Ralim/Open-BMS/README.md

# Open-BMS
ISL94202 &amp; MSP430 based BMS

This is the source files for the Open BMS Designed by Ben V. Brown.
Documentation is currently over at [Hackaday.io](https://hackaday.io/project/25512-open-bms).
