Ralim/Open-BMS/Electronics/BMS GUI/Front Panel.pdf

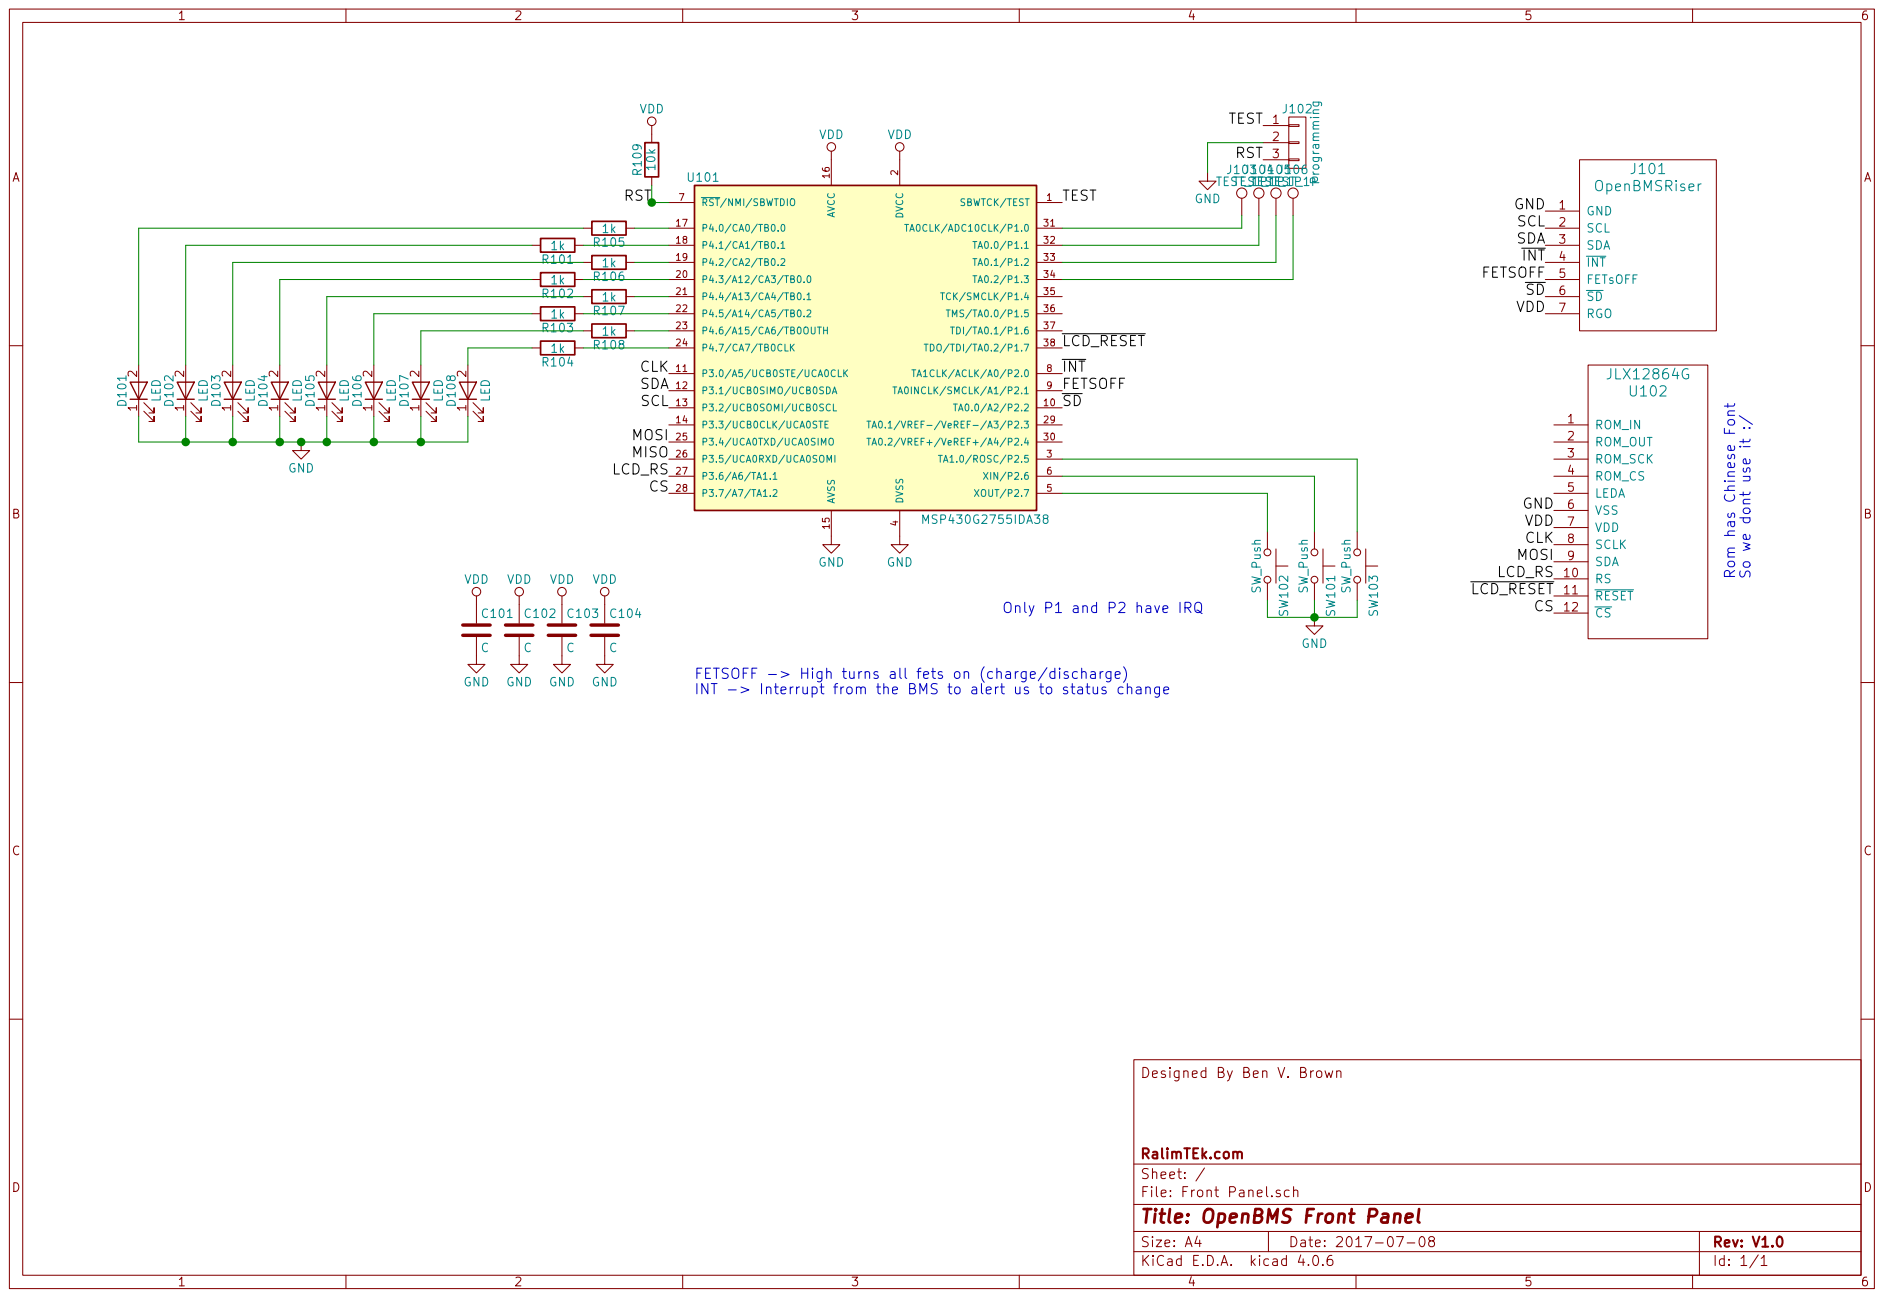
[picture p1: page 1]

4 XOUT/P2.7 5 XIN/P2.6 6 RST/NMI/SBWTDIO 7 TA1CLK/ACLK/A0/P2.0 8 TA0INCLK/SMCLK/A1/P2.1 9 TA0.0/A2/P2.2 10 P4.3/A12/CA3/TB0.0 20 TA0.2/VREF+/VeREF+/A4/P2.4 30 P3.0/A5/UCB0STE/UCA0CLK 11 P4.4/A13/CA4/TB0.1 21 TA0CLK/ADC10CLK/P1.0 31 P3.1/UCB0SIMO/UCB0SDA 12 P4.5/A14/CA5/TB0.2 22 TA0.0/P1.1 32 P3.2/UCB0SOMI/UCB0SCL 13 P4.6/A15/CA6/TB0OUTH 23 TA0.1/P1.2 33 P3.3/UCB0CLK/UCA0STE 14 P4.7/CA7/TB0CLK 24 TA0.2/P1.3 34 AVSS 15 P3.4/UCA0TXD/UCA0SIMO 25 TCK/SMCLK/P1.4 35 AVCC 16 P3.5/UCA0RXD/UCA0SOMI 26 TMS/TA0.0/P1.5 36 P4.0/CA0/TB0.0 17 P3.6/A6/TA1.1 27 TDI/TA0.1/P1.6 37 P4.1/CA1/TB0.1 18 P3.7/A7/TA1.2 28 TDO/TDI/TA0.2/P1.7 38 P4.2/CA2/TB0.2 19 TA0.1/VREF/VeREF/A3/P2.3 29 U101 MSP430G2755IDA38 VDD VDD GND GND GND 1 SCL 2 SDA 3

RST GND Only P1 and P2 have IRQ

FETSOFF -> High turns all fets on (charge/discharge)
INT -> Interrupt from the BMS to alert us to status change

Designed By Ben V. Brown

Id: 1/1 Title: OpenBMS Front Panel File: Front Panel.sch Sheet: / RalimTEk.com
