Ralim/Open-BMS/Electronics/Power Dist/Power Dist.kicad_pcb

## KiCad design Electronics/Power Dist/Power Dist.kicad_pcb (2017-08-22)

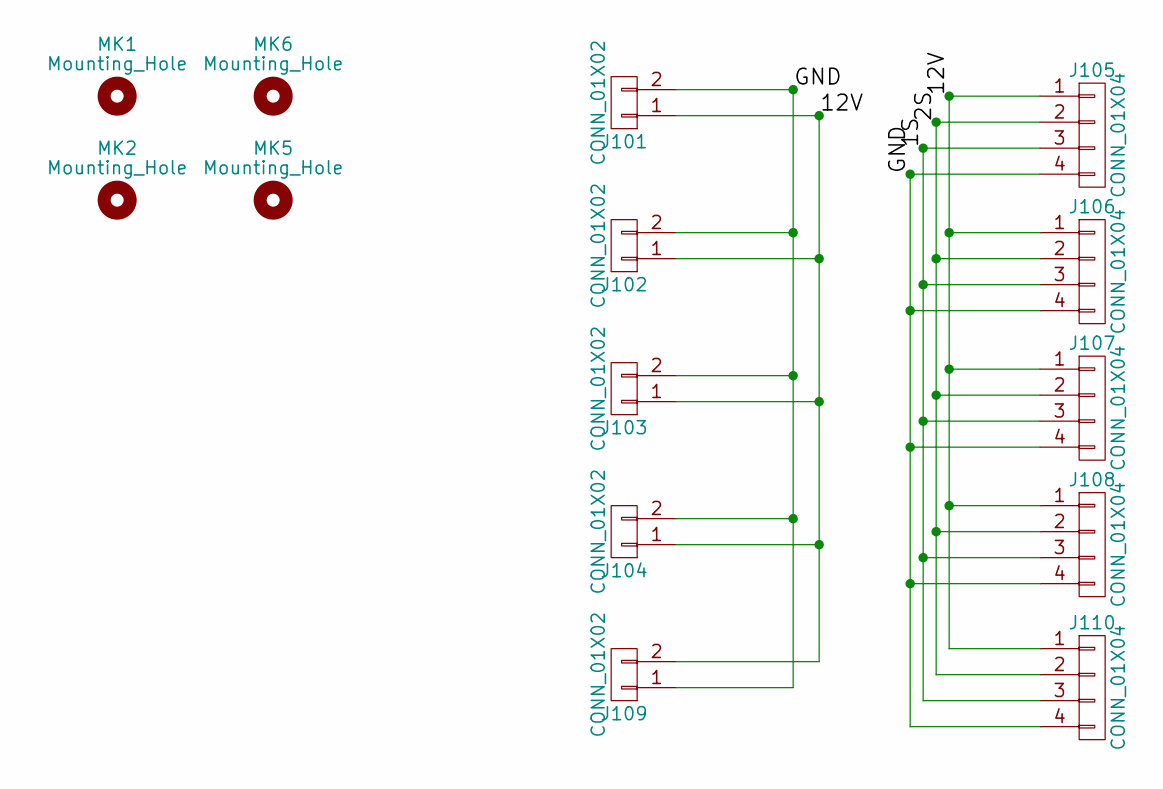
[picture p2: schematic Power Dist.sch]

Parts:
J101: CONN_01X02; XT30PW_Female
J102, J103, J104: CONN_01X02; XT30PW_Male
J105, J106, J107, J108: CONN_01X04; JST_XH_S04B-XH-A_04x2.50mm_Angled
J109: CONN_01X02; XT30
J110: CONN_01X04; JST_XH_B04B-XH-A_04x2.50mm_Straight
MK1, MK2, MK5, MK6: Mounting_Hole; MountingHole_3.2mm_M3

Connections:
/1S: J105.3, J106.3, J107.3, J108.3, J110.3
/2S: J105.2, J106.2, J107.2, J108.2, J110.2
/12V: J101.1, J102.1, J103.1, J104.1, J105.1, J106.1, J107.1, J108.1, J109.2, J110.1
/GND: J101.2, J102.2, J103.2, J104.2, J105.4, J106.4, J107.4, J108.4, J109.1, J110.4

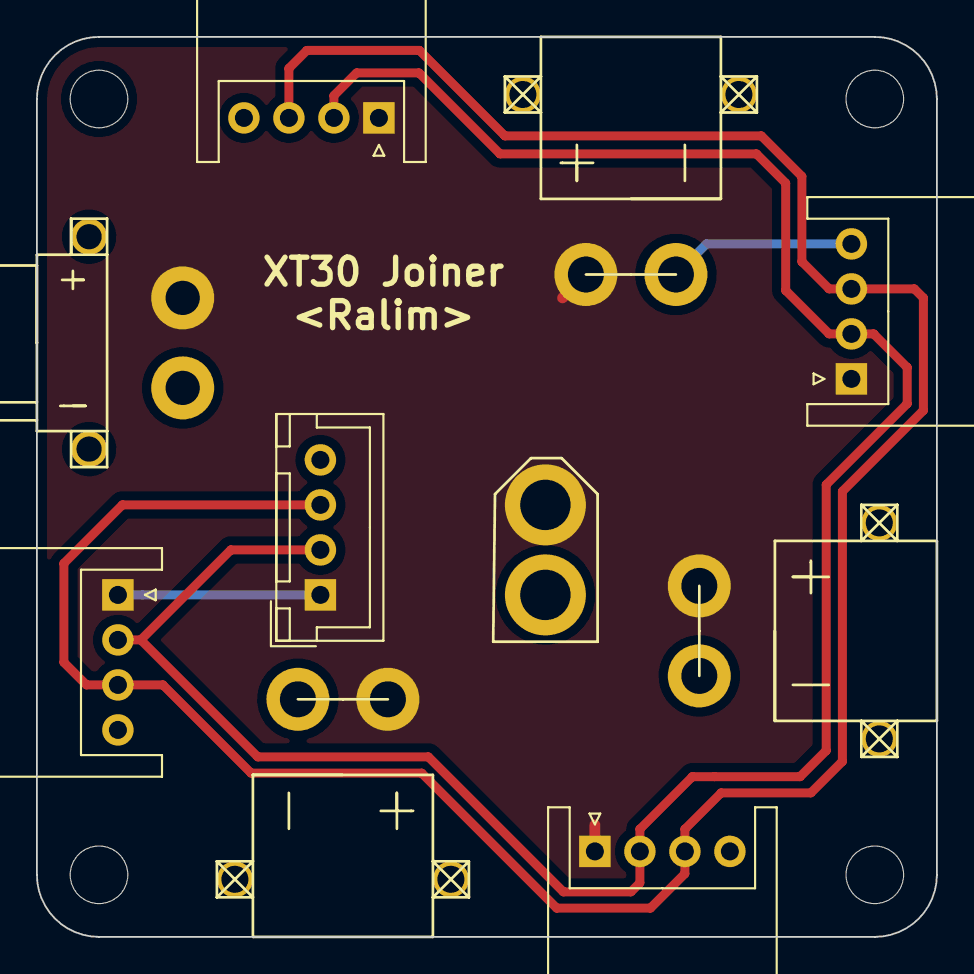
[picture p3: board Power Dist.kicad_pcb from above]

Board: 2 copper layers, 50.0 x 50.0 mm, 14 parts (0 on the bottom side), 4 nets.
