Ralim/Open-BMS/Electronics/BMS GUI/Front Panel.kicad_pcb

## KiCad design Electronics/BMS GUI/Front Panel.kicad_pcb (2017-07-08)

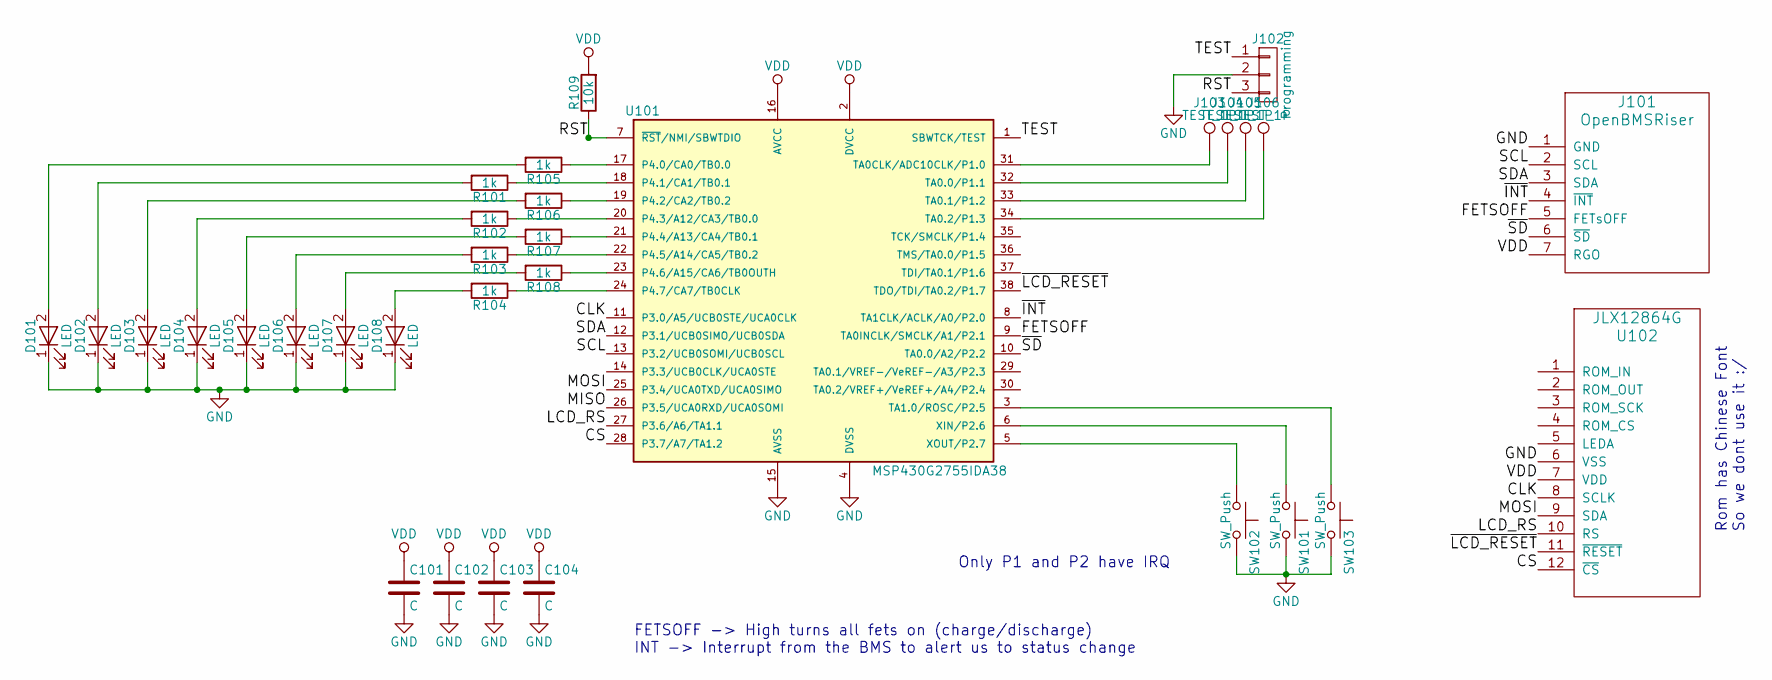
[picture p4: schematic Front Panel.sch, OpenBMS Front Panel]

Parts:
C101, C102, C103, C104: C; C_0603
D101, D102, D103, D104, D105, D106, D107, D108: LED; LED_0805
J101: OpenBMSRiser
J102: Programming; Pin_Header_Angled_1x03_Pitch2.54mm
J103, J104, J105, J106: TEST_1P; TEST-SMD-SMALL
R101, R102, R103, R104, R105, R106, R107, R108: 1k; R_0603
R109: 10k; R_0603
SW101, SW102, SW103: SW_Push; SW_SPST_TL3342
U101: MSP430G2755IDA38; TSSOP-38_4.4x9.7mm_Pitch0.5mm
U102: JLX12864G

Connections:
/CLK: U101.11 (P3.0/A5/UCB0STE/UCA0CLK), U102.8 (SCLK)
/CS: U101.28 (P3.7/A7/TA1.2), U102.12 (~CS)
/FETSOFF: J101.5 (FETsOFF), U101.9 (TA0INCLK/SMCLK/A1/P2.1)
/LCD_RS: U101.27 (P3.6/A6/TA1.1), U102.10 (RS)
/MOSI: U101.25 (P3.4/UCA0TXD/UCA0SIMO), U102.9 (SDA)
/RST: J102.3, R109.1, U101.7 (~RST~/NMI/SBWTDIO)
/SCL: J101.2 (SCL), U101.13 (P3.2/UCB0SOMI/UCB0SCL)
/SDA: J101.3 (SDA), U101.12 (P3.1/UCB0SIMO/UCB0SDA)
/TEST: J102.1, U101.1 (SBWTCK/TEST)
/~INT: J101.4 (~INT), U101.8 (TA1CLK/ACLK/A0/P2.0)
/~LCD_RESET: U101.38 (TDO/TDI/TA0.2/P1.7), U102.11 (~RESET)
/~SD: J101.6 (~SD), U101.10 (TA0.0/A2/P2.2)
GND: C101.2, C102.2, C103.2, C104.2, D101.1 (K), D102.1 (K), D103.1 (K), D104.1 (K), D105.1 (K), D106.1 (K), D107.1 (K), D108.1 (K), J101.1 (GND), J102.2, SW101.2, SW102.2, SW103.2, U101.4 (DVSS), U101.15 (AVSS), U102.6 (VSS)
unnamed: D101.2 (A), R105.2
unnamed: D102.2 (A), R101.2
unnamed: D103.2 (A), R106.2
unnamed: D104.2 (A), R102.2
unnamed: D105.2 (A), R107.2
unnamed: D106.2 (A), R103.2
unnamed: D107.2 (A), R108.2
unnamed: D108.2 (A), R104.2
unnamed: J103.1, U101.31 (TA0CLK/ADC10CLK/P1.0)
unnamed: J104.1, U101.32 (TA0.0/P1.1)
unnamed: J105.1, U101.33 (TA0.1/P1.2)
unnamed: J106.1, U101.34 (TA0.2/P1.3)
unnamed: R101.1, U101.18 (P4.1/CA1/TB0.1)
unnamed: R102.1, U101.20 (P4.3/A12/CA3/TB0.0)
unnamed: R103.1, U101.22 (P4.5/A14/CA5/TB0.2)
unnamed: R104.1, U101.24 (P4.7/CA7/TB0CLK)
unnamed: R105.1, U101.17 (P4.0/CA0/TB0.0)
unnamed: R106.1, U101.19 (P4.2/CA2/TB0.2)
unnamed: R107.1, U101.21 (P4.4/A13/CA4/TB0.1)
unnamed: R108.1, U101.23 (P4.6/A15/CA6/TB0OUTH)
unnamed: SW101.1, U101.6 (XIN/P2.6)
unnamed: SW102.1, U101.5 (XOUT/P2.7)
unnamed: SW103.1, U101.3 (TA1.0/ROSC/P2.5)
VDD: C101.1, C102.1, C103.1, C104.1, J101.7 (RGO), R109.2, U101.2 (DVCC), U101.16 (AVCC), U102.7 (VDD)

Notes on the sheet:
Rom has Chinese Font So we dont use it :/
Only P1 and P2 have IRQ
FETSOFF -> High turns all fets on (charge/discharge) INT -> Interrupt from the BMS to alert us to status change

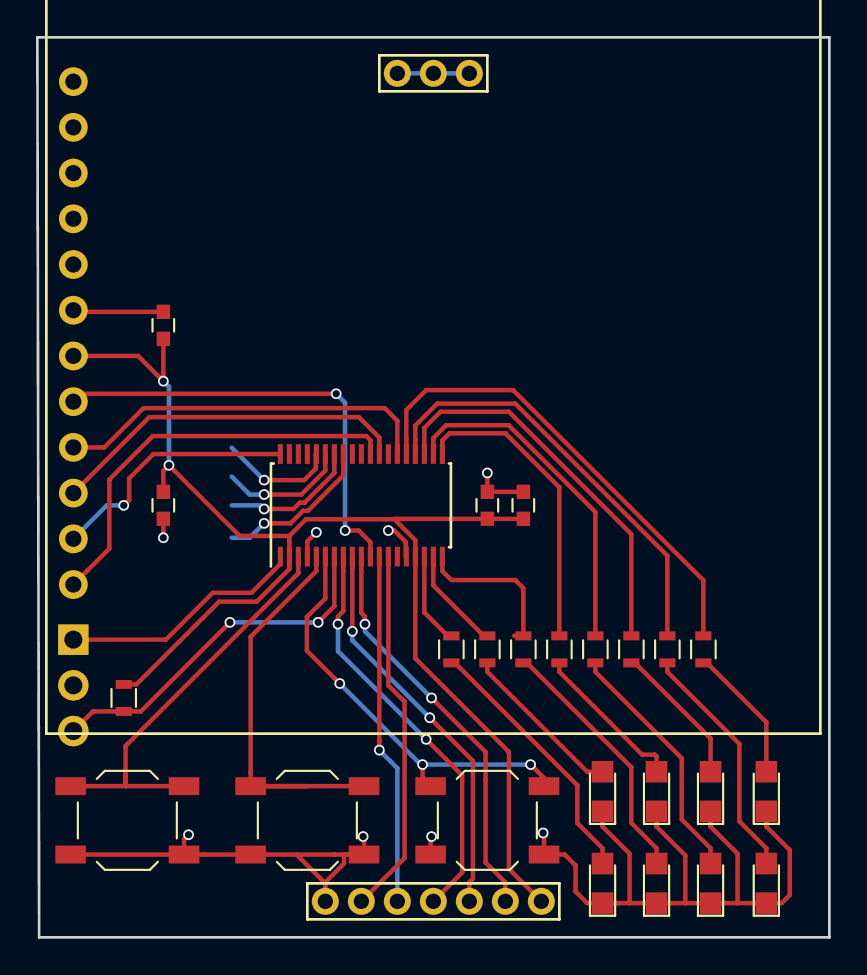
[picture p5: board Front Panel.kicad_pcb from above]

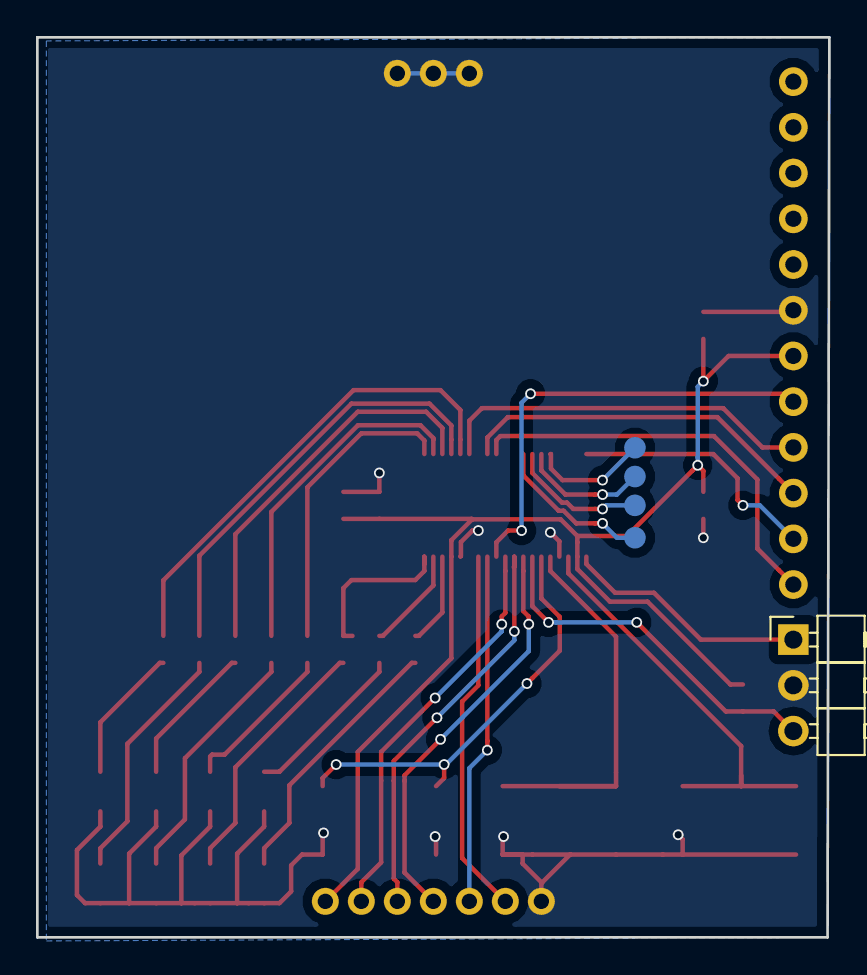
[picture p6: board Front Panel.kicad_pcb from below]

Board: 2 copper layers, 44.0 x 50.0 mm, 32 parts (5 on the bottom side), 37 nets.
