Ralim/Open-BMS/Electronics/BMS FrontEnd/OpenBMSFrontEnd.kicad_pcb

## KiCad design Electronics/BMS FrontEnd/OpenBMSFrontEnd.kicad_pcb (2017-06-20)

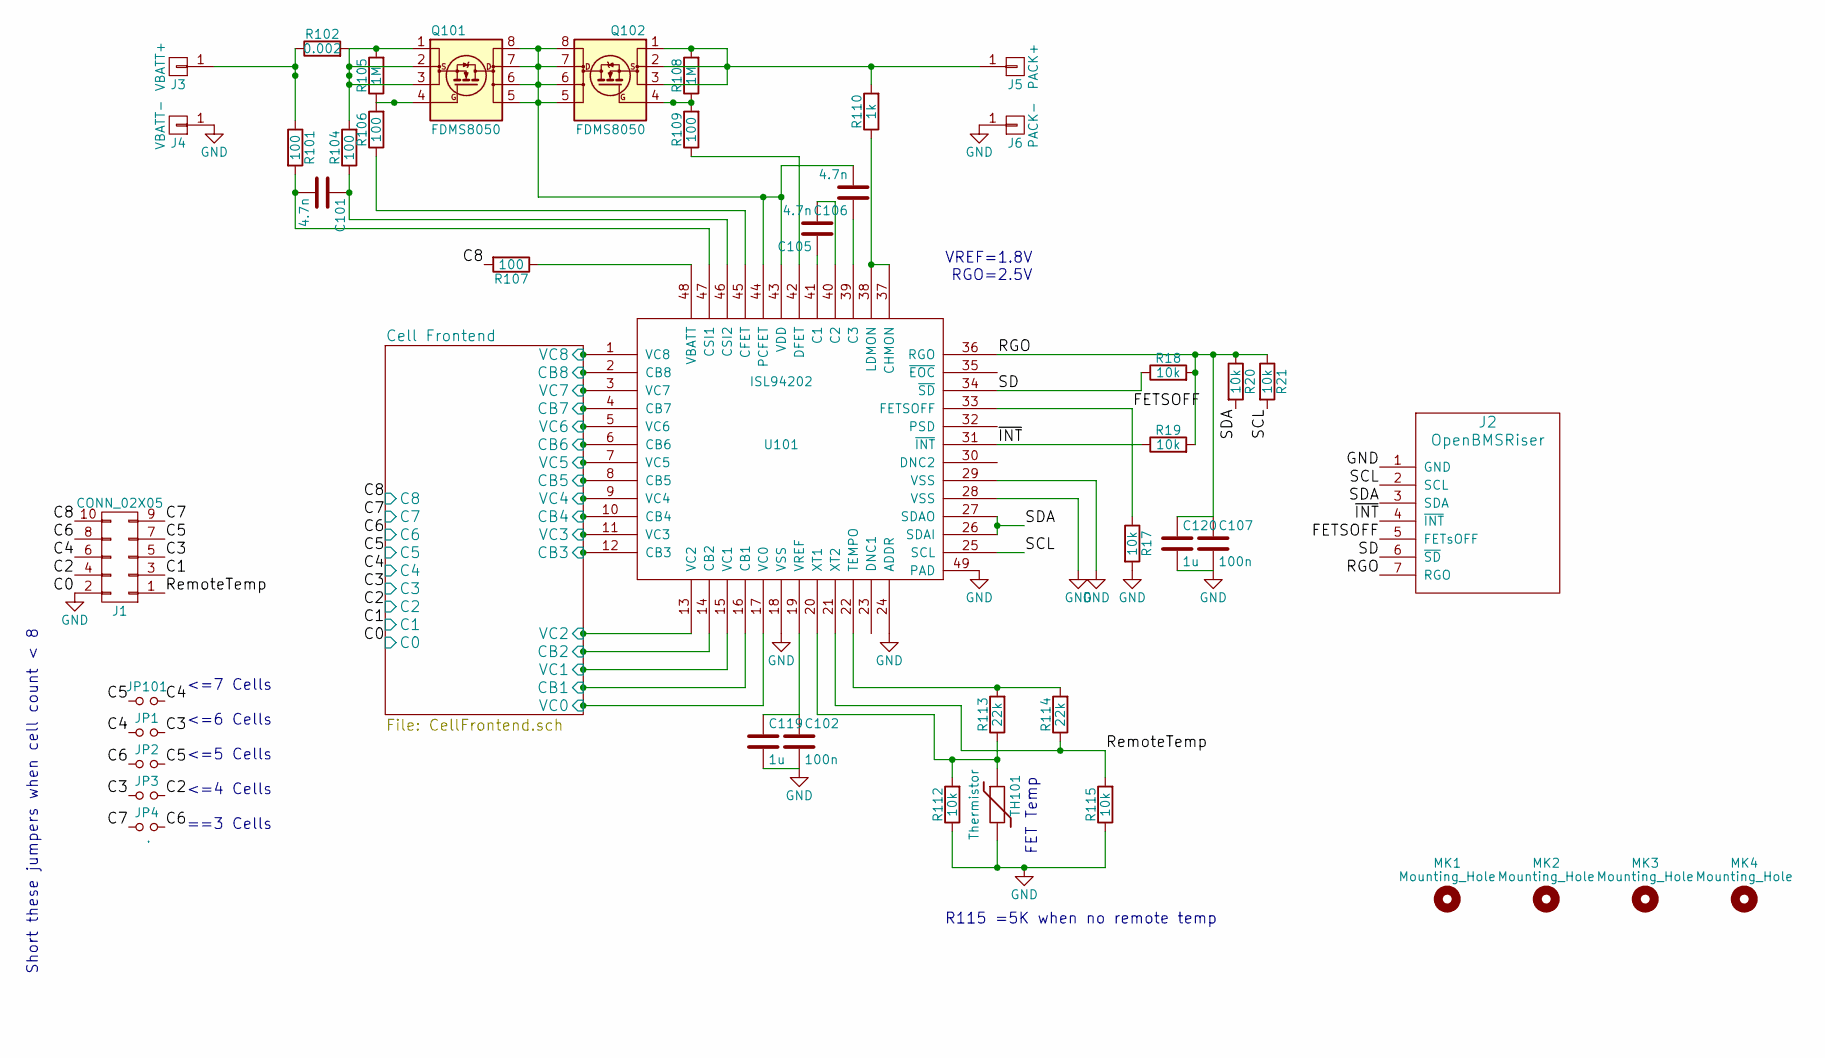
[picture p7: schematic OpenBMSFrontEnd.sch, Open BMS Front End]

Parts:
C101, C105, C106: 4.7n; C_0603
C102, C107: 100n; C_0603
C119, C120: 1u; C_0603
J1: CONN_02X05; IDC_Header_Straight_10pins
J2: OpenBMSRiser
J3: VBATT+; SolderWirePad_single_2mmDrill
J4: VBATT-; SolderWirePad_single_2mmDrill
J5: PACK+; SolderWirePad_single_2mmDrill
J6: PACK-; SolderWirePad_single_2mmDrill
JP1, JP2, JP3, JP4, JP101: .; JUMPER-SOLDER-SMD
MK1, MK2, MK3, MK4: Mounting_Hole; MountingHole_3.2mm_M3
Q101, Q102: FDMS8050; TDSON-8-1
R17, R18, R19, R20, R21, R112, R115: 10k; R_0603
R101, R104, R106, R107, R109: 100; R_0603
R102: 0.002; R_2512
R105, R108: 1M; R_0603
R110: 1k; R_0603
R113, R114: 22k; R_0603
TH101: Thermistor; R_0603
U101: ISL94202; UQFN-48-1EP_6x6mm_Pitch0.4mm

Connections:
/C1: J1.3; also elsewhere on the board
/C2: J1.4, JP3.2; also elsewhere on the board
/C3: J1.5, JP1.2, JP3.1; also elsewhere on the board
/C4: J1.6, JP1.1, JP101.2; also elsewhere on the board
/C5: J1.7, JP2.2, JP101.1; also elsewhere on the board
/C6: J1.8, JP2.1, JP4.2; also elsewhere on the board
/C7: J1.9, JP4.1; also elsewhere on the board
/C8: J1.10, R107.2; also elsewhere on the board
/Cell Frontend/CB1: U101.16 (CB1); also elsewhere on the board
/Cell Frontend/CB2: U101.14 (CB2); also elsewhere on the board
/Cell Frontend/CB3: U101.12 (CB3); also elsewhere on the board
/Cell Frontend/CB4: U101.10 (CB4); also elsewhere on the board
/Cell Frontend/CB5: U101.8 (CB5); also elsewhere on the board
/Cell Frontend/CB6: U101.6 (CB6); also elsewhere on the board
/Cell Frontend/CB7: U101.4 (CB7); also elsewhere on the board
/Cell Frontend/CB8: U101.2 (CB8); also elsewhere on the board
/Cell Frontend/VC0: U101.17 (VC0); also elsewhere on the board
/Cell Frontend/VC1: U101.15 (VC1); also elsewhere on the board
/Cell Frontend/VC2: U101.13 (VC2); also elsewhere on the board
/Cell Frontend/VC3: U101.11 (VC3); also elsewhere on the board
/Cell Frontend/VC4: U101.9 (VC4); also elsewhere on the board
/Cell Frontend/VC5: U101.7 (VC5); also elsewhere on the board
/Cell Frontend/VC6: U101.5 (VC6); also elsewhere on the board
/Cell Frontend/VC7: U101.3 (VC7); also elsewhere on the board
/Cell Frontend/VC8: U101.1 (VC8); also elsewhere on the board
/FETSOFF: J2.5 (FETsOFF), R17.1, U101.33 (FETSOFF)
/RGO: C107.1, C120.1, J2.7 (RGO), R18.2, R19.2, R20.1, R21.1, U101.36 (RGO)
/RemoteTemp: J1.1, R114.1, R115.2, U101.21 (XT2)
/SCL: J2.2 (SCL), R21.2, U101.25 (SCL)
/SD: J2.6 (~SD), R18.1, U101.34 (~SD)
/SDA: J2.3 (SDA), R20.2, U101.26 (SDAI), U101.27 (SDAO)
/~INT: J2.4 (~INT), R19.1, U101.31 (~INT)
GND: C102.2, C107.2, C119.2, C120.2, J1.2, J2.1 (GND), J4.1, J6.1, R17.2, R112.1, R115.1, TH101.2, U101.18 (VSS), U101.24 (ADDR), U101.28 (VSS), U101.29 (VSS), U101.49 (PAD); also elsewhere on the board
unnamed: C101.1, R104.1, U101.46 (CSI2)
unnamed: C101.2, R101.2, U101.47 (CSI1)
unnamed: C102.1, C119.1, U101.19 (VREF)
unnamed: C105.1, U101.41 (C1)
unnamed: C105.2, U101.40 (C2)
unnamed: C106.1, U101.39 (C3)
unnamed: C106.2, Q101.5 (D), Q101.6 (D), Q101.7 (D), Q101.8 (D), Q102.5 (D), Q102.6 (D), Q102.7 (D), Q102.8 (D), U101.43 (VDD), U101.44 (PCFET)
unnamed: J3.1, R101.1, R102.1
unnamed: J5.1, Q102.1 (S), Q102.2 (S), Q102.3 (S), R108.2, R110.2
unnamed: Q101.1 (S), Q101.2 (S), Q101.3 (S), R102.2, R104.2, R105.2
unnamed: Q101.4 (G), R105.1, R106.2
unnamed: Q102.4 (G), R108.1, R109.2
unnamed: R106.1, U101.45 (CFET)
unnamed: R107.1, U101.48 (VBATT)
unnamed: R109.1, U101.42 (DFET)
unnamed: R110.1, U101.37 (CHMON), U101.38 (LDMON)
unnamed: R112.2, R113.1, TH101.1, U101.20 (XT1)
unnamed: R113.2, R114.2, U101.22 (TEMPO)

Notes on the sheet:
VREF=1.8V RGO=2.5V
FET Temp
<=7 Cells <=6 Cells <=5 Cells <=4 Cells ==3 Cells
Short these jumpers when cell count < 8
R115 =5K when no remote temp

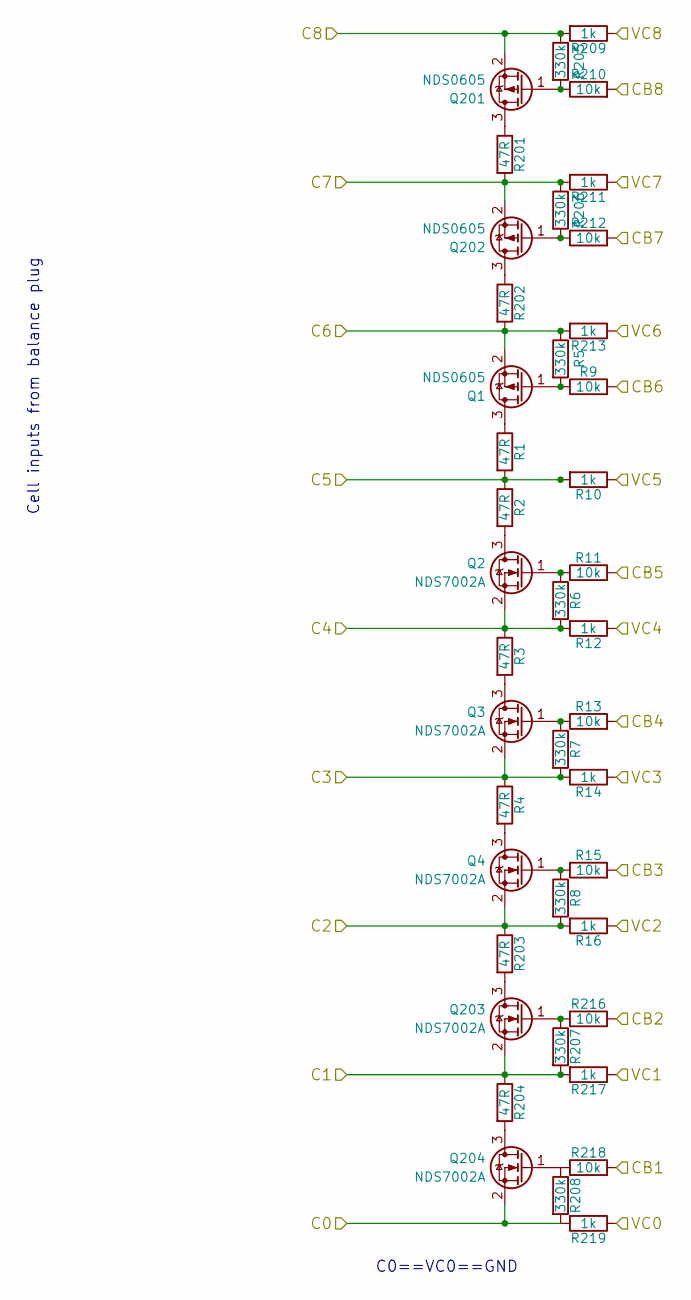
[picture p8: schematic CellFrontend.sch, BMS Front End Balancing Drive]

Parts:
Q1, Q201, Q202: NDS0605; SOT-23
Q2, Q3, Q4, Q203, Q204: NDS7002A; SOT-23
R1, R2, R3, R4, R201, R202, R203, R204: 47R; R_0805
R5, R6, R7, R8, R205, R206, R207, R208: 330k; R_0603
R9, R11, R13, R15, R210, R212, R216, R218: 10k; R_0603
R10, R12, R14, R16, R209, R211, R213, R217, R219: 1k; R_0603

Connections:
/C1: Q203.2 (S), R204.1, R207.2, R217.2; also elsewhere on the board
/C2: Q4.2 (S), R8.2, R16.2, R203.1; also elsewhere on the board
/C3: Q3.2 (S), R4.1, R7.2, R14.2; also elsewhere on the board
/C4: Q2.2 (S), R3.1, R6.2, R12.2; also elsewhere on the board
/C5: R1.2, R2.1, R10.2; also elsewhere on the board
/C6: Q1.2 (S), R5.1, R202.2, R213.2; also elsewhere on the board
/C7: Q202.2 (S), R201.2, R206.1, R211.2; also elsewhere on the board
/C8: Q201.2 (S), R205.1, R209.2; also elsewhere on the board
/Cell Frontend/CB1: R218.2; also elsewhere on the board
/Cell Frontend/CB2: R216.2; also elsewhere on the board
/Cell Frontend/CB3: R15.2; also elsewhere on the board
/Cell Frontend/CB4: R13.2; also elsewhere on the board
/Cell Frontend/CB5: R11.2; also elsewhere on the board
/Cell Frontend/CB6: R9.2; also elsewhere on the board
/Cell Frontend/CB7: R212.2; also elsewhere on the board
/Cell Frontend/CB8: R210.2; also elsewhere on the board
/Cell Frontend/VC0: R219.1; also elsewhere on the board
/Cell Frontend/VC1: R217.1; also elsewhere on the board
/Cell Frontend/VC2: R16.1; also elsewhere on the board
/Cell Frontend/VC3: R14.1; also elsewhere on the board
/Cell Frontend/VC4: R12.1; also elsewhere on the board
/Cell Frontend/VC5: R10.1; also elsewhere on the board
/Cell Frontend/VC6: R213.1; also elsewhere on the board
/Cell Frontend/VC7: R211.1; also elsewhere on the board
/Cell Frontend/VC8: R209.1; also elsewhere on the board
GND: Q204.2 (S), R208.2, R219.2; also elsewhere on the board
unnamed: Q1.1 (G), R5.2, R9.1
unnamed: Q1.3 (D), R1.1
unnamed: Q2.1 (G), R6.1, R11.1
unnamed: Q2.3 (D), R2.2
unnamed: Q3.1 (G), R7.1, R13.1
unnamed: Q3.3 (D), R3.2
unnamed: Q4.1 (G), R8.1, R15.1
unnamed: Q4.3 (D), R4.2
unnamed: Q201.1 (G), R205.2, R210.1
unnamed: Q201.3 (D), R201.1
unnamed: Q202.1 (G), R206.2, R212.1
unnamed: Q202.3 (D), R202.1
unnamed: Q203.1 (G), R207.1, R216.1
unnamed: Q203.3 (D), R203.2
unnamed: Q204.1 (G), R208.1, R218.1
unnamed: Q204.3 (D), R204.2

Notes on the sheet:
Cell inputs from balance plug
C0==VC0==GND

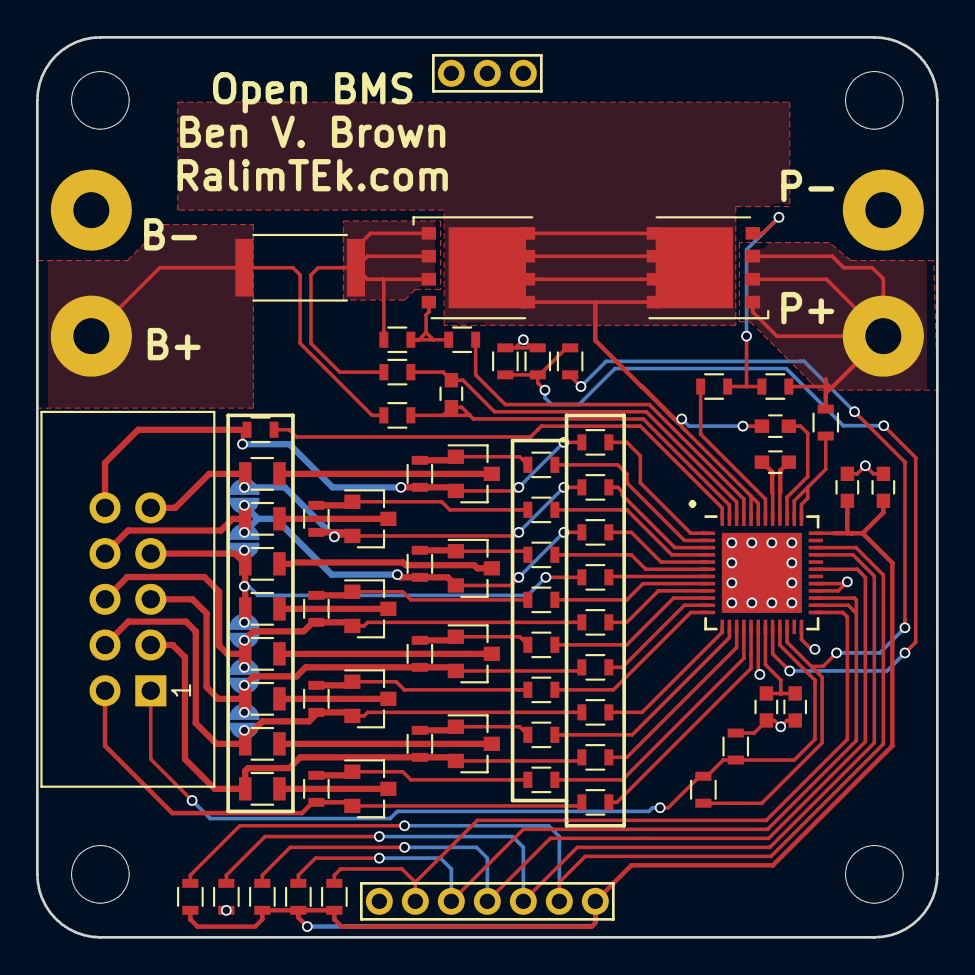
[picture p9: board OpenBMSFrontEnd.kicad_pcb from above]

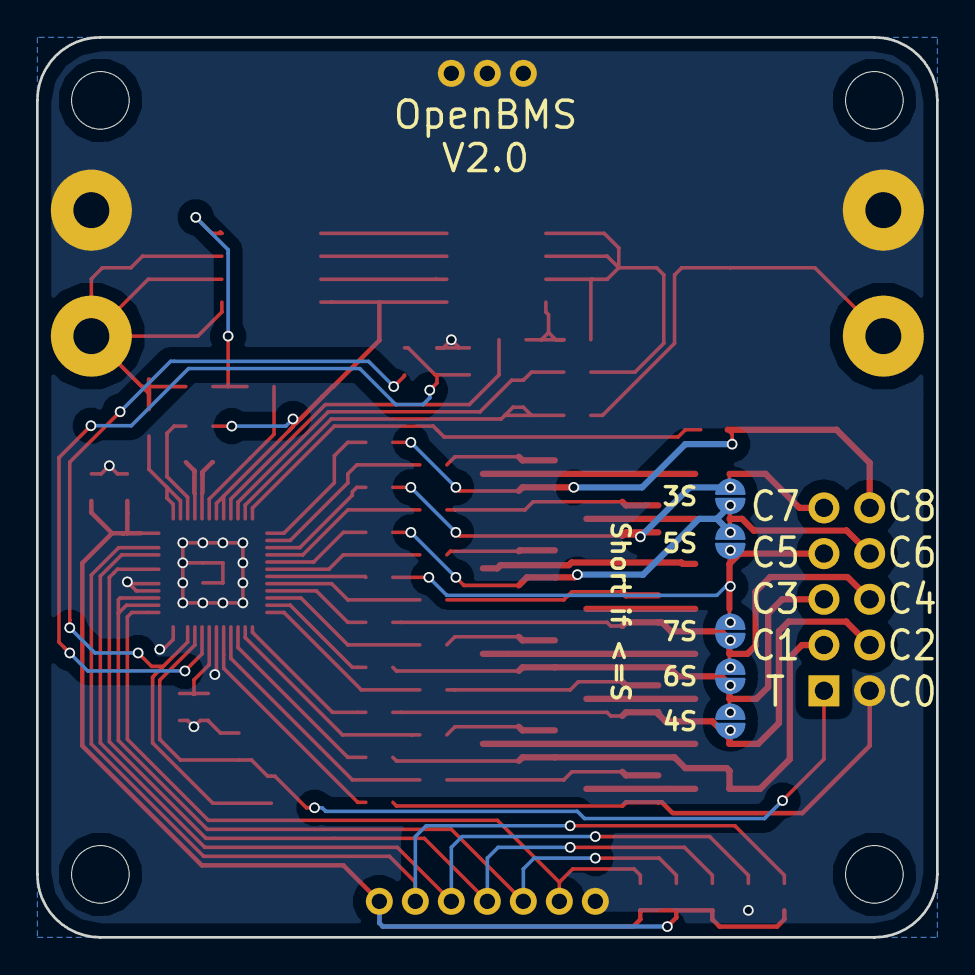
[picture p10: board OpenBMSFrontEnd.kicad_pcb from below]

Board: 2 copper layers, 50.0 x 50.0 mm, 85 parts (5 on the bottom side), 67 nets.
