Ralim/Open-BMS/Front Panel Code/OpenBMS/setup.h

/*
 * setup.h
 *
 *  Created on: 11Jun.,2017
 *      Author: Ben V. Brown
 */

#ifndef SETUP_H_
#define SETUP_H_
#include <msp430.h>
#include "hardware.h"
#include "i2c.h"
void setup();



#endif /* SETUP_H_ */
