Ralim/Open-BMS/(commit log)

2017-06-18 Check In Baseboard & tester code
    + KiCad Design for base of the unit
    +Inital ISL code for I2C on the MSP430
    [CellFrontend.sch, OpenBMSFrontEnd.kicad_pcb, OpenBMSFrontEnd.sch]
2017-06-20 User Interface board layout rough pass
    [Front Panel.kicad_pcb, Front Panel.sch, OpenBMSFrontEnd.kicad_pcb]
2017-07-08 Finish layout of front panel
    [Front Panel.kicad_pcb, Front Panel.sch]
2017-08-22 Add Power Dist PCB
    [Power Dist.kicad_pcb, Power Dist.sch]
2017-08-26 LCD printing working now
2017-08-27 Timer working
2017-08-29 Starting drawing the battery voltages for testing
